MasaCTC/retrolink-ecu/simulation/Signal Conditioning Simulation.asc

C1: cap; 100nF
R1: res; 4.7K
R2: res; 10K
R3: res; 1K
U1: opamp2
V1: voltage; SINE(2.5 2.5 100)
Named nets: 0, TO_ADC
Feedback wire
.tran 50m
.lib C:\\users\\crossover\\AppData\\Local\\LTspice\\lib\\sub\\myopamp.sub
