MasaCTC/retrolink-ecu/RetroLink/Core/Src/main.c

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
/* Includes ------------------------------------------------------------------*/
#include "main.h"
#include "cmsis_os.h"

/* USER CODE BEGIN Includes */

#include <stdio.h>
#include <string.h>
#include "ssd1306.h"

/* USER CODE END Includes */

/* USER CODE BEGIN PD */

/*--- Voltage divider scaling (ADC mV → sensor-side mV) ---
 * Your signal conditioning circuit divides 5V sensor range down to
 * 3.3V ADC-safe range. To recover the original sensor voltage:
 *   sensor_mv = adc_mv * VDIV_NUM / VDIV_DEN
 *
 * Bench testing (pot wired direct to PA0/PA1): 1/1 = no scaling.
 * Vehicle (through 5V→3.3V divider):          50/33 ≈ 1.515x.
 */
#define VDIV_NUM  1
#define VDIV_DEN  1

/* TPS calibration points (sensor-side millivolts).
 * FSM spec: VTA = 0.1–1.0V closed, ~3.5V WOT.
 * For bench testing, set these to your pot's actual range.
 * For vehicle use, restore to 500 / 3500. */
#define TPS_MV_CLOSED      0
#define TPS_MV_WOT      2250

/* USER CODE END PD */

ADC_HandleTypeDef hadc1;

CAN_HandleTypeDef hcan1;

I2C_HandleTypeDef hi2c1;

UART_HandleTypeDef huart2;

/* Definitions for sensorTask */
osThreadId_t sensorTaskHandle;
const osThreadAttr_t sensorTask_attributes = {
  .name = "sensorTask",
  .stack_size = 128 * 4,
  .priority = (osPriority_t) osPriorityAboveNormal,
};
/* Definitions for canTask */
osThreadId_t canTaskHandle;
const osThreadAttr_t canTask_attributes = {
  .name = "canTask",
  .stack_size = 128 * 4,
  .priority = (osPriority_t) osPriorityNormal,
};
/* Definitions for displayTask */
osThreadId_t displayTaskHandle;
const osThreadAttr_t displayTask_attributes = {
  .name = "displayTask",
  .stack_size = 256 * 4,
  .priority = (osPriority_t) osPriorityBelowNormal,
};
/* USER CODE BEGIN PV */

volatile uint16_t adc_raw[2];		// Raw 12-bit ADC readings (0-4095)
volatile float sensor_voltage[2];	// Converted voltage (0-3.3V)

/* USER CODE END PV */

void SystemClock_Config(void);
static void MX_GPIO_Init(void);
static void MX_ADC1_Init(void);
static void MX_CAN1_Init(void);
static void MX_I2C1_Init(void);
static void MX_USART2_UART_Init(void);
void StartSensorTask(void *argument);
void StartCanTask(void *argument);
void StartDisplayTask(void *argument);

/* USER CODE BEGIN PFP */
static int16_t clt_voltage_to_celsius(int sensor_mv);
static int     tps_voltage_to_percent(int sensor_mv);
/* USER CODE END PFP */

/* USER CODE BEGIN 0 */

/*--- CLT lookup table: sensor-side millivolts → temperature °C ---
 * Data from 3VZ-E NTC thermistor specs (89422-20010) with ~2.2kΩ
 * pull-up to 5V reference. Voltage DECREASES as temp rises because
 * NTC resistance drops, pulling the divider output lower.
 *
 * The table is sorted by decreasing voltage (= increasing temp).
 * clt_voltage_to_celsius() walks the table and linearly interpolates
 * between the two nearest points.
 */
typedef struct {
    int16_t  temp_c;  /* temperature in °C */
    uint16_t mv;      /* sensor-side voltage in millivolts */
} CLT_Point;

static const CLT_Point clt_table[] = {
    { -20, 4400 },
    {   0, 3600 },
    {  20, 2700 },
    {  40, 1700 },
    {  60, 1000 },
    {  80,  600 },
    { 100,  500 },
    { 120,  300 },
};
#define CLT_TABLE_SIZE  (sizeof(clt_table) / sizeof(clt_table[0]))

/**
 * @brief  Convert sensor-side millivolts to coolant temperature in °C.
 *         Uses piecewise linear interpolation between table points.
 * @param  sensor_mv  Voltage at the CLT sensor pin (millivolts)
 * @retval Temperature in °C (clamped to table range: -20 to 120)
 */
static int16_t clt_voltage_to_celsius(int sensor_mv)
{
    /* Clamp to table endpoints */
    if (sensor_mv >= (int)clt_table[0].mv)
        return clt_table[0].temp_c;                       /* very cold */
    if (sensor_mv <= (int)clt_table[CLT_TABLE_SIZE - 1].mv)
        return clt_table[CLT_TABLE_SIZE - 1].temp_c;      /* very hot  */

    /* Walk the table — voltage decreases as index increases */
    for (int i = 0; i < (int)CLT_TABLE_SIZE - 1; i++) {
        if (sensor_mv <= (int)clt_table[i].mv &&
            sensor_mv >= (int)clt_table[i + 1].mv)
        {
            /* Linear interpolation:
             *   fraction = (upper_mv - sensor_mv) / (upper_mv - lower_mv)
             *   temp = upper_temp + fraction * (lower_temp - upper_temp)
             *
             * All integer math — multiply before divide to keep precision. */
            int dv = clt_table[i].mv - clt_table[i + 1].mv;     /* positive */
            int dt = clt_table[i + 1].temp_c - clt_table[i].temp_c; /* positive */
            int offset = clt_table[i].mv - sensor_mv;
            return clt_table[i].temp_c + (int16_t)((offset * dt) / dv);
        }
    }
    return -99; /* should never reach here */
}

/**
 * @brief  Convert sensor-side millivolts to throttle position 0–100%.
 *         Simple linear interpolation between closed and WOT voltages.
 * @param  sensor_mv  Voltage at the TPS VTA pin (millivolts)
 * @retval Throttle position percentage, clamped to 0–100
 */
static int tps_voltage_to_percent(int sensor_mv)
{
    if (sensor_mv <= TPS_MV_CLOSED) return 0;
    if (sensor_mv >= TPS_MV_WOT)   return 100;
    return ((sensor_mv - TPS_MV_CLOSED) * 100) / (TPS_MV_WOT - TPS_MV_CLOSED);
}

/* USER CODE END 0 */

/**
  * @brief  The application entry point.
  * @retval int
  */
int main(void)
{

  /* MCU Configuration--------------------------------------------------------*/

  /* Reset of all peripherals, Initializes the Flash interface and the Systick. */
  HAL_Init();

  /* Configure the system clock */
  SystemClock_Config();

  /* Initialize all configured peripherals */
  MX_GPIO_Init();
  MX_ADC1_Init();
  MX_CAN1_Init();
  MX_I2C1_Init();
  MX_USART2_UART_Init();
  /* USER CODE BEGIN 2 */

  // Pull-up on CAN_RX (PB8) so the peripheral sees recessive (high)
  // during the init-to-normal transition
  GPIO_InitTypeDef canrx_fix = {0};
  canrx_fix.Pin = GPIO_PIN_8;
  canrx_fix.Mode = GPIO_MODE_AF_PP;
  canrx_fix.Pull = GPIO_PULLUP;
  canrx_fix.Speed = GPIO_SPEED_FREQ_VERY_HIGH;
  canrx_fix.Alternate = GPIO_AF9_CAN1;
  HAL_GPIO_Init(GPIOB, &canrx_fix);

  CAN_FilterTypeDef filter;
  filter.FilterBank = 0;
  filter.FilterMode = CAN_FILTERMODE_IDMASK;
  filter.FilterScale = CAN_FILTERSCALE_32BIT;
  filter.FilterIdHigh = 0x0000;
  filter.FilterIdLow = 0x0000;
  filter.FilterMaskIdHigh = 0x0000;
  filter.FilterMaskIdLow = 0x0000;
  filter.FilterFIFOAssignment = CAN_RX_FIFO0;
  filter.FilterActivation = ENABLE;
  HAL_CAN_ConfigFilter(&hcan1, &filter);

  HAL_CAN_Start(&hcan1);
  HAL_CAN_ActivateNotification(&hcan1, CAN_IT_RX_FIFO0_MSG_PENDING);

  /* USER CODE END 2 */

  /* Init scheduler */
  osKernelInitialize();

  /* USER CODE BEGIN RTOS_MUTEX */
  /* add mutexes, ... */
  /* USER CODE END RTOS_MUTEX */

  /* USER CODE BEGIN RTOS_SEMAPHORES */
  /* add semaphores, ... */
  /* USER CODE END RTOS_SEMAPHORES */

  /* USER CODE BEGIN RTOS_TIMERS */
  /* start timers, add new ones, ... */
  /* USER CODE END RTOS_TIMERS */

  /* USER CODE BEGIN RTOS_QUEUES */
  /* add queues, ... */
  /* USER CODE END RTOS_QUEUES */

  /* Create the thread(s) */
  /* creation of sensorTask */
  sensorTaskHandle = osThreadNew(StartSensorTask, NULL, &sensorTask_attributes);

  /* creation of canTask */
  canTaskHandle = osThreadNew(StartCanTask, NULL, &canTask_attributes);

  /* creation of displayTask */
  displayTaskHandle = osThreadNew(StartDisplayTask, NULL, &displayTask_attributes);

  /* USER CODE BEGIN RTOS_THREADS */
  /* add threads, ... */
  /* USER CODE END RTOS_THREADS */

  /* USER CODE BEGIN RTOS_EVENTS */
  /* add events, ... */
  /* USER CODE END RTOS_EVENTS */

  /* Start scheduler */
  osKernelStart();

  /* We should never get here as control is now taken by the scheduler */

  /* Infinite loop */
  /* USER CODE BEGIN WHILE */
  while (1)
  {
    /* USER CODE END WHILE */

    /* USER CODE BEGIN 3 */
  }
  /* USER CODE END 3 */
}

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
/* USER CODE BEGIN 4 */

void HAL_CAN_RxFifo0MsgPendingCallback(CAN_HandleTypeDef *hcan)
{
  CAN_RxHeaderTypeDef rx_header;
  uint8_t rx_data[8];
  HAL_CAN_GetRxMessage(hcan, CAN_RX_FIFO0, &rx_header, rx_data);
  if (rx_header.StdId == 0x100)
  {
    HAL_GPIO_TogglePin(GPIOA, GPIO_PIN_5);
  }
}

/* USER CODE END 4 */

/* USER CODE BEGIN Header_StartSensorTask */
/**
  * @brief  Function implementing the sensorTask thread.
  * 		Starts the ADC, waits for the conversion to finish,
  * 		reads the 12-bit result (0-4095), converts to voltage
  * 		([raw / 4095] * 3.3V), then repeats for second channel.
  * 		Has a 10 Hz sample rate.
  * @param  argument: Not used
  * @retval None
  */
/* USER CODE END Header_StartSensorTask */
void StartSensorTask(void *argument)
{
  /* USER CODE BEGIN 5 */
	/* The ADC has a multiplexer (mux) that selects which pin to read.
	 * HAL_ADC_Start() does NOT change the selected channel — only
	 * HAL_ADC_ConfigChannel() does. So we must call ConfigChannel
	 * before each conversion to switch between PA0 and PA1. */
	ADC_ChannelConfTypeDef sConfig = {0};
	sConfig.Rank = 1;
	sConfig.SamplingTime = ADC_SAMPLETIME_3CYCLES;

	for(;;) {
	  // Select Channel 0 (PA0) - coolant temperature sensor
	  sConfig.Channel = ADC_CHANNEL_0;
	  HAL_ADC_ConfigChannel(&hadc1, &sConfig);
	  HAL_ADC_Start(&hadc1);
	  if (HAL_ADC_PollForConversion(&hadc1, 10) == HAL_OK) {
		  adc_raw[0] = HAL_ADC_GetValue(&hadc1);
		  sensor_voltage[0] = (float)adc_raw[0] * 3.3f / 4095.0f;
	  }
	  HAL_ADC_Stop(&hadc1);

	  // Select Channel 1 (PA1) - TPS
	  sConfig.Channel = ADC_CHANNEL_1;
	  HAL_ADC_ConfigChannel(&hadc1, &sConfig);
	  HAL_ADC_Start(&hadc1);
	  if (HAL_ADC_PollForConversion(&hadc1, 10) == HAL_OK) {
		  adc_raw[1] = HAL_ADC_GetValue(&hadc1);
		  sensor_voltage[1] = (float)adc_raw[1] * 3.3f / 4095.0f;
	  }
	  HAL_ADC_Stop(&hadc1);

	  osDelay(100);
	}
  /* USER CODE END 5 */
}

/* USER CODE BEGIN Header_StartCanTask */
/**
* @brief Function implementing the canTask thread.
* 		 Sets up a CAN transmit header with message ID 0x100
* 		 - StdId: an 11-bit identifier that tells receivers
* 		   "this frame contains sensor data"
* 		 - DLC: Data Length Code = 4 bytes, 2 per sensor
* 		 - RTR: DATA frame (not a Remote request)
* 		 Packs the two raw ADC values into the data payload
* 		 - Each value is 12-bit (0-4095), which fits in 2 bytes
* 		 - High byte first, then low byte (big-endian)
* 		 Sends the frame on the CAN bus
* 		 Has a 5 Hz transmit rate
* @param argument: Not used
* @retval None
*/
/* USER CODE END Header_StartCanTask */
void StartCanTask(void *argument)
{
  /* USER CODE BEGIN StartCanTask */

	CAN_TxHeaderTypeDef tx_header;
	uint8_t tx_data[8];
	uint32_t tx_mailbox;

	// COnfigure the CAN frame header
	tx_header.StdId = 0x100;					// Arbitration ID
	tx_header.ExtId = 0;						// Not using extended ID
	tx_header.RTR = CAN_RTR_DATA;				// Data frame, not remote request
	tx_header.IDE = CAN_ID_STD;				// Standard 11-bit ID
	tx_header.DLC = 4;						// 4 bytes of data
	tx_header.TransmitGlobalTime = DISABLE;

	for (;;) {
	  // Pack sensor 0 into bytes 0-1 (big-endian)
	  tx_data[0] = (adc_raw[0] >> 8) & 0xFF;
	  tx_data[1] = adc_raw[0] & 0xFF;

	  // Pack sensor 1 inot bytes 2-3 (big-endian)
	  tx_data[2] = (adc_raw[1] >> 8) & 0xFF;
	  tx_data[3] = adc_raw[1] & 0xFF;

	  // Transmit - HAL puts it in the next available mailbox
	  HAL_CAN_AddTxMessage(&hcan1, &tx_header, tx_data, &tx_mailbox);

	  osDelay(200);
	}
  /* USER CODE END StartCanTask */
}

/* USER CODE BEGIN Header_StartDisplayTask */
/**
* @brief Function implementing the displayTask thread.
* @param argument: Not used
* @retval None
*/
/* USER CODE END Header_StartDisplayTask */
void StartDisplayTask(void *argument)
{
  /* USER CODE BEGIN StartDisplayTask */
	char buf[32];

	/* Initialize the OLED — sends the startup command sequence
	 * and clears the screen. Must happen once before drawing. */
	ssd1306_Init(&hi2c1);

	for(;;) {
		/* Convert raw ADC counts to millivolts, then scale
		 * through the voltage divider to get sensor-side mV. */
		int adc_mv0 = (adc_raw[0] * 3300) / 4095;
		int adc_mv1 = (adc_raw[1] * 3300) / 4095;
		int sen_mv0 = (adc_mv0 * VDIV_NUM) / VDIV_DEN;
		int sen_mv1 = (adc_mv1 * VDIV_NUM) / VDIV_DEN;

		/* Run the conversions */
		int16_t clt_c   = clt_voltage_to_celsius(sen_mv0);
		int     tps_pct = tps_voltage_to_percent(sen_mv1);

		/* Clear the framebuffer, then draw fresh content */
		ssd1306_Fill(SSD1306_COLOR_BLACK);

		/* Title bar */
		ssd1306_SetCursor(0, 0);
		ssd1306_WriteString("RetroLink", Font_11x18, SSD1306_COLOR_WHITE);

		/* Divider line under the title */
		ssd1306_DrawHLine(0, 20, 128, SSD1306_COLOR_WHITE);

		/* Sensor 0 — coolant temp: engineering unit + raw voltage */
		sprintf(buf, "CLT: %d C", (int)clt_c);
		ssd1306_SetCursor(0, 24);
		ssd1306_WriteString(buf, Font_7x10, SSD1306_COLOR_WHITE);

		sprintf(buf, "%d.%02dV", adc_mv0/1000, (adc_mv0%1000)/10);
		ssd1306_SetCursor(84, 24);
		ssd1306_WriteString(buf, Font_7x10, SSD1306_COLOR_WHITE);

		/* Sensor 1 — throttle position: engineering unit + raw voltage */
		sprintf(buf, "TPS: %d%%", tps_pct);
		ssd1306_SetCursor(0, 38);
		ssd1306_WriteString(buf, Font_7x10, SSD1306_COLOR_WHITE);

		sprintf(buf, "%d.%02dV", adc_mv1/1000, (adc_mv1%1000)/10);
		ssd1306_SetCursor(84, 38);
		ssd1306_WriteString(buf, Font_7x10, SSD1306_COLOR_WHITE);

		/* Push the framebuffer to the display */
		ssd1306_UpdateScreen();

		/* UART: engineering units + raw voltage for debugging */
		int len = sprintf(buf, "CLT:%dC(%dmV) TPS:%d%%(%dmV)\r\n",
		                  (int)clt_c, adc_mv0, tps_pct, adc_mv1);
		HAL_UART_Transmit(&huart2, (uint8_t *)buf, len, 100);

		osDelay(500);
	}
  /* USER CODE END StartDisplayTask */
}

/**
  * @brief  This function is executed in case of error occurrence.
  * @retval None
  */
void Error_Handler(void)
{
  /* USER CODE BEGIN Error_Handler_Debug */
  /* User can add his own implementation to report the HAL error return state */
  __disable_irq();
  while (1)
  {
  }
  /* USER CODE END Error_Handler_Debug */
}
#ifdef USE_FULL_ASSERT
/**
  * @brief  Reports the name of the source file and the source line number
  *         where the assert_param error has occurred.
  * @param  file: pointer to the source file name
  * @param  line: assert_param error line source number
  * @retval None
  */
void assert_failed(uint8_t *file, uint32_t line)
{
  /* USER CODE BEGIN 6 */
  /* User can add his own implementation to report the file name and line number,
     ex: printf("Wrong parameters value: file %s on line %d\r\n", file, line) */
  /* USER CODE END 6 */
}
#endif /* USE_FULL_ASSERT */
