MasaCTC/retrolink-ecu/RetroLink/RetroLink.ioc

Mcu.UserName=STM32F446RETx
PA0-WKUP.Signal=ADCx_IN0
PA1.Signal=ADCx_IN1
PA2.Signal=USART2_TX
PA3.Signal=USART2_RX
PB6.Signal=I2C1_SCL
PB7.Signal=I2C1_SDA
PB8.Signal=CAN1_RX
PB9.Signal=CAN1_TX
