MasaCTC/retrolink-ecu/(commit log)

2026-07-04 Add circuit schematic and waveform screenshots
2026-07-04 Add STM32CubeMX project: ADC1, CAN1, I2C1, USART2, FreeRTOS
2026-07-04 Update status: STM32CubeMX project configured
2026-07-05 Add FreeRTOS tasks: sensorTask, canTask, displayTask
2026-07-07 Implement sensorTask and displayTask with ADC reading and UART output
2026-07-09 feat: CAN loopback verified - ADC + CAN TX working
    - Added CAN task code (500kbps, ID 0x100, 4-byte payload)
    - Configured CAN loopback mode with corrected baud rate (Prescaler=2, BS1=13, BS2=2)
    - Fixed CAN init failure: added GPIO_PULLUP on PB8 (CAN_RX) so peripheral
    sees recessive bits during init-to-normal transition
    - Added CAN RX callback with LED toggle for loopback verification
    - Signal conditioning circuit tested: 3.3V->2.25V, 5V->2.60V, GND->0V
    - Configured PA5 as GPIO output for LD2 LED
    - Enabled CAN1 RX0 NVIC interrupt
    [RetroLink.ioc, main.c]
2026-07-12 feat: CAN normal mode verified with TJA1050 transceiver
    - Switched from loopback to normal mode
    - TJA1050 wired: VCC/GND/TXD(PB9)/RXD(PB8)
    - Confirmed ACK errors only (no bus/bit/CRC errors) - expected with single node
    - CAN_H bus voltage ~2.2V confirms transceiver driving the bus
    - Cleaned up debug prints
    [main.c]
2026-07-13 feat: add SSD1306 OLED driver and live sensor display
2026-07-16 Fix TPS calibration range for bench pot (0-2.25V)
    [main.c]
